sebastian-silaghi/Bandgap-Voltage-Reference/README.md

# Bandgap-Voltage-Reference

Brokaw bandgap voltage reference topology implementation and design.
Internal CMOS technology transistor-level operational amplifier design.
Low PVT variations with second-order compensation.
Low quiescent current and high precision.
The reference voltage remains stable over a wide temperature range (-40°C - 150°C), supply voltage variations (1.6V - 2V) and process.

## Tools
- LTSpice
- Analog design principles

## Results
- Reference voltage ≈ 1.2 V
- Overall PVT variation < 25 mV
