sebastian-silaghi/Bandgap-Voltage-Reference/Documentation/Design of a Bandgap Voltage Reference.pdf

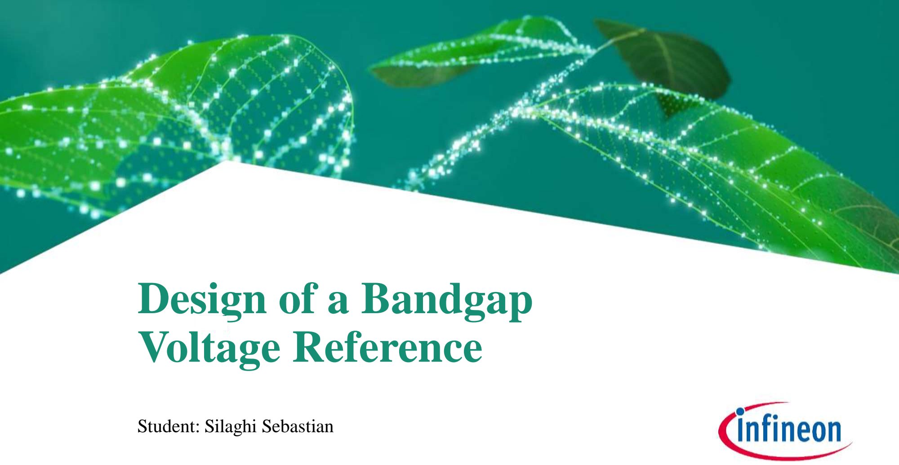
[picture p1: page 1]

# Design of a Bandgap Voltage Reference

Student: Silaghi Sebastian

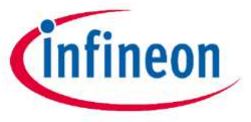
[picture p2: figure]

# Table of Contents

## 1. Bandgap voltage reference design

1.1. Requirements
1.2. Topology
1.3. Operational amplifier design
1.4. Start-up circuit

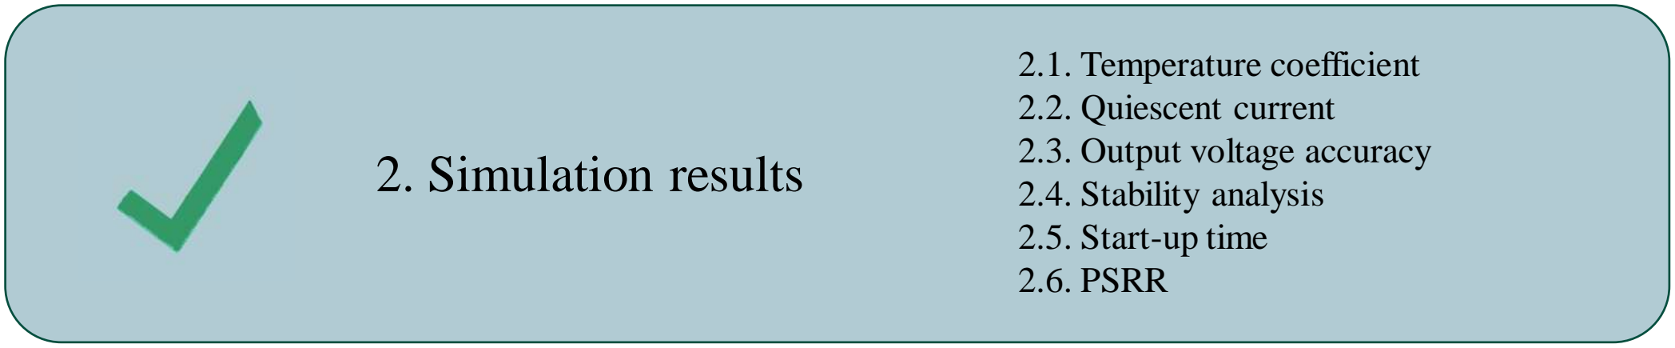
[picture p3: figure]
2. Simulation results; 2.1. Temperature coefficient 2.2. Quiescent current 2.3. Output voltage accuracy 2.4. Stability analysis 2.5. Start-up time 2.6. PSRR

# 1. Bandgap voltage reference design

# 1.1. Requirements

Parameter | Test condition | Min. Value | Typ. Value | Max. Value | Unit
Output voltage | PVT | - | 1.2 | - | V
Precision | - | -3 | - | 3 | %
Supply voltage | - | 1.6 | 1.8 | 2 | V
Resistance tolerance | - | -1 | - | +1 | %
Quiescent current | PVT | - | 30 | - | µA

Tabel 1. Reference voltage requirements

# 1.2. Topology – Brokaw bandgap design steps

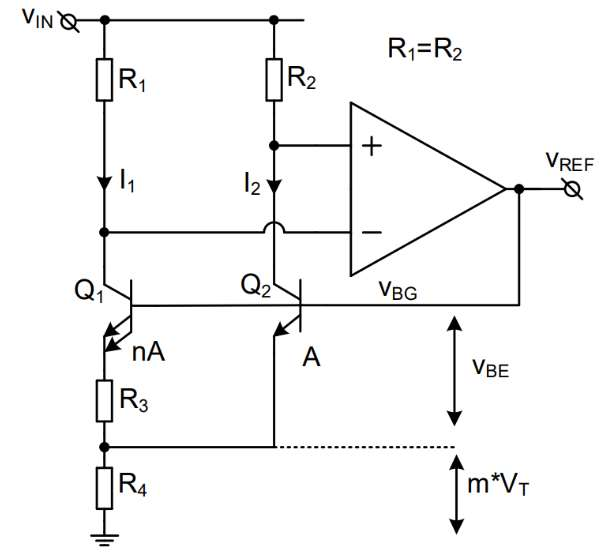
[picture p4: figure]

Figure 1. Voltage reference schematic

The output voltage of the circuit is:

The zero-temperature coefficient condition:

### ∂vBG

∂T

= 0

⇒

2R4
R3

### ⋅ ln n = 23.25

# 1.2. Topology – Brokaw bandgap design steps

Figure 2. Voltage reference schematic

2R4
R3

### ⋅ ln n = 23.25

n = 8

⇒

R4
R3

= 5.6

I1 = I2 = 6µA ⇒

### R3 = 11.2kΩ

### R4 = 55.2kΩ

R1 = R2 ≈

Vin − VBG
I2

≈ 100kΩ

# 1.3. Operational amplifier design – Miller OTA

Main requirements:
a0 > 60dB
PM > 40deg
GM > 10dB
CL = 1pF
IAO = 15µA

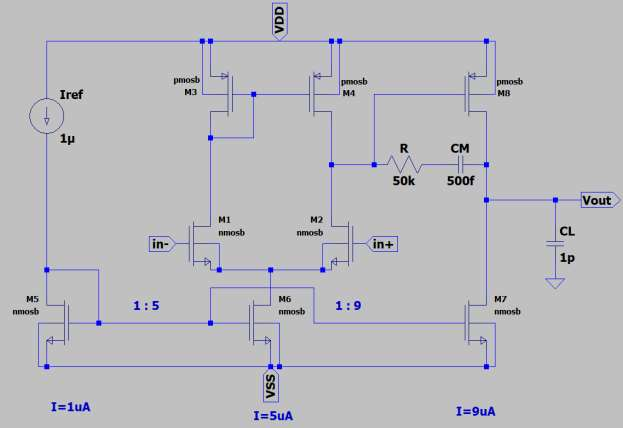
[picture p5: figure]

Figure 3. Schematic of the Miller OTA

Obtained parameters:
a0 = 85dB
PM = 65deg
GM = 15dB
IAO ≈ 15µA
SR = 12V/µs
GBW = 22MHz

# 1.3. Operational amplifier design – Miller OTA

M | Idref | (W/L)ref | Vdsatref | Vthref
NMOS | 50µA | 5µm/1µm | 240mV | 450mV
PMOS | 50µA | 15µm/1µm | 257mV | 450mV

Tabel 2. Reference set transistors

For the sizing of each transistor: Idref Id

=

### WΤL rⅇf WΤL

### Vdsatref Vdsat

2

# 1.3. Operational amplifier design – Miller OTA

M | Id[A] | Vds[V] | Vdsat[V] | gm[S] | W[m] | L[m]
M5 | 1.00E-06 | 6.06E-01 | 1.48E-01 | 1.21E-05 | 2.60E-07 | 1.00E-06
M6 | 4.97E-06 | 1.02E+00 | 1.50E-01 | 5.84E-05 | 1.30E-06 | 1.00E-06
M1 | 2.49E-06 | 3.46E-01 | 6.61E-02 | 5.27E-05 | 5.76E-06 | 1.00E-06
M2 | 2.49E-06 | 3.46E-01 | 6.61E-02 | 5.27E-05 | 5.76E-06 | 1.00E-06
M3 | 2.49E-06 | 6.31E-01 | 1.60E-01 | 2.43E-05 | 2.19E-06 | 1.00E-06
M4 | 2.49E-06 | 6.31E-01 | 1.60E-01 | 2.43E-05 | 2.19E-06 | 1.00E-06
M7 | 9.02E-06 | 1.50E+00 | 1.50E-01 | 1.05E-04 | 2.30E-06 | 1.00E-06
M8 | 9.02E-06 | 5.03E-01 | 1.63E-01 | 8.82E-05 | 7.89E-06 | 1.00E-06
Tabel 3. Miller OTA transistors

# 1.4. Start-up circuit – working principle

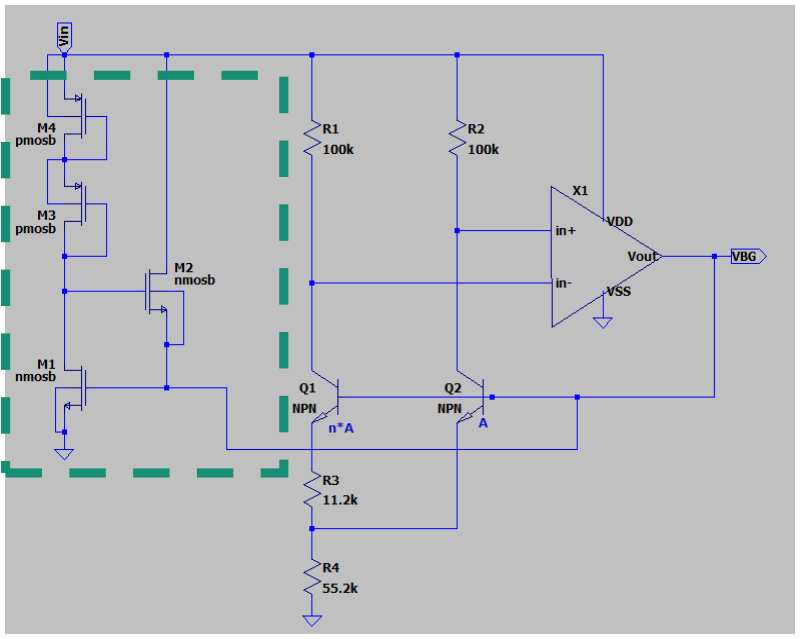
[picture p6: figure]

Figure 4. Bandgap start-up circuit

When VBG = 0 M1 - off, M2 - on and pulls down the gate of M3, M4 => M3, M4 - on and source current from Vin into the core.

When VBG ↑ M1 - on and forces M2 - off and loses its ability to pull down the gate of M3, M4 => M3, M4 - off and no current flowing

# 1.4. Start-up circuit – transient behavior

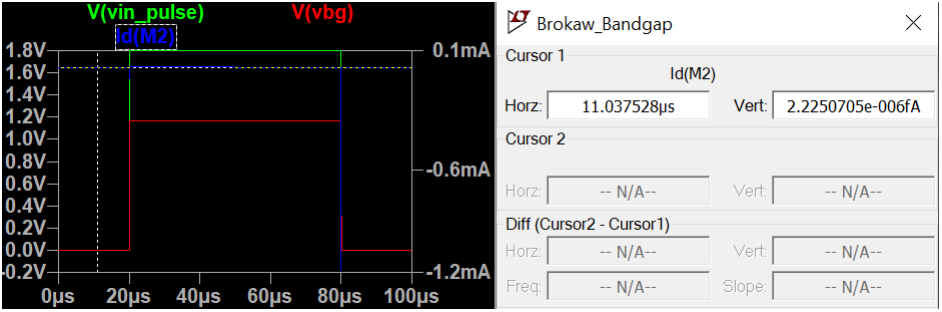
[picture p7: figure]

Figure 5. Transient behavior of start-up circuit

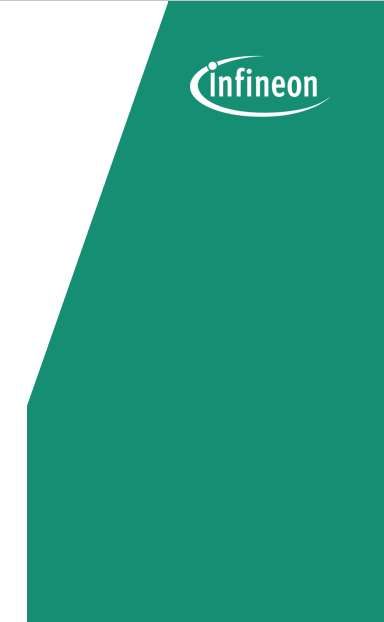
[picture p8: figure]

# 2. Simulation results

# 2.1. Temperature coefficient

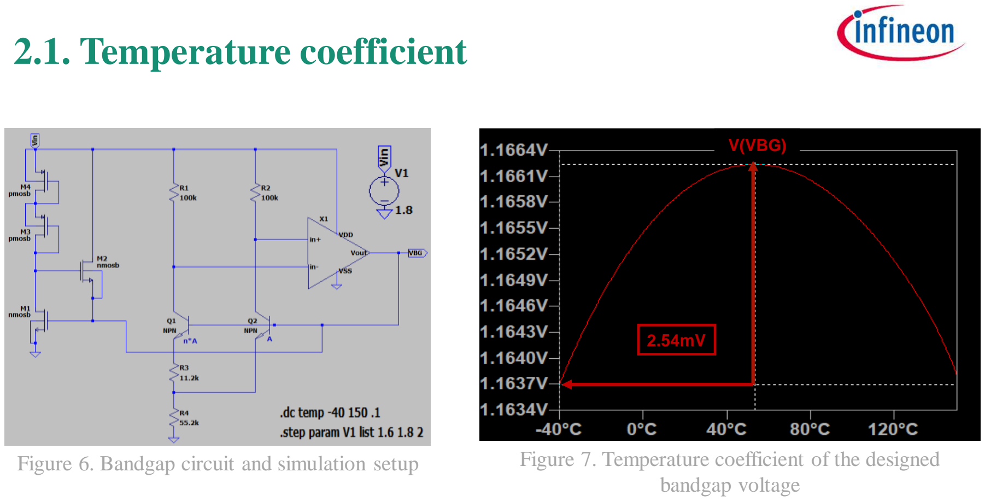
[picture p9: page 13]

Figure 6. Bandgap circuit and simulation setup | Figure 7. Temperature coefficient of the designed bandgap voltage

2.54mV

V(VBG)

## 2.2. Quiescent current – variation with temperature

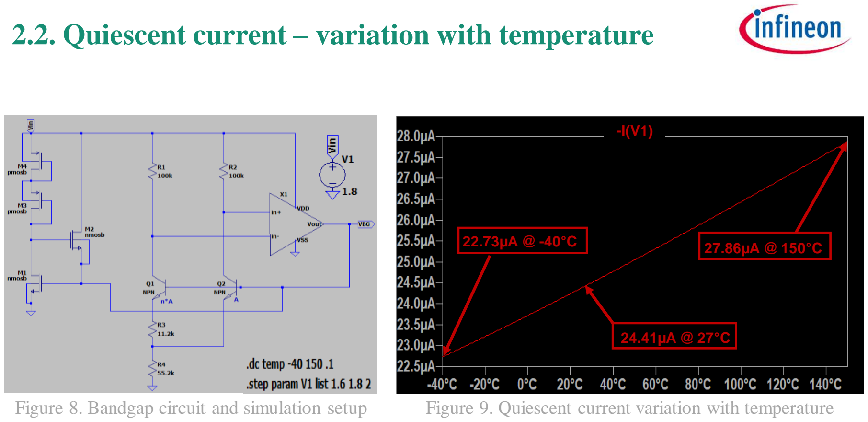
[picture p10: page 14]

Figure 8. Bandgap circuit and simulation setup | Figure 9. Quiescent current variation with temperature

22.73µA @ -40°C

24.41µA @ 27°C

27.86µA @ 150°C

-I(V1)

## 2.2. Quiescent current – variation with supply voltage

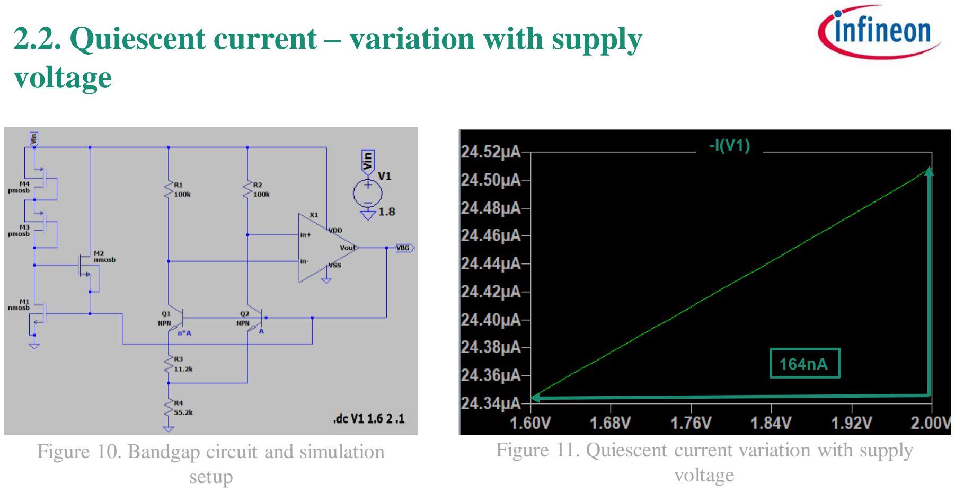
[picture p11: page 15]

Figure 10. Bandgap circuit and simulation setup

Figure 11. Quiescent current variation with supply voltage

164nA

-I(V1)

## 2.2. Quiescent current – MC300 variation with process (resistor tolerance 1%)

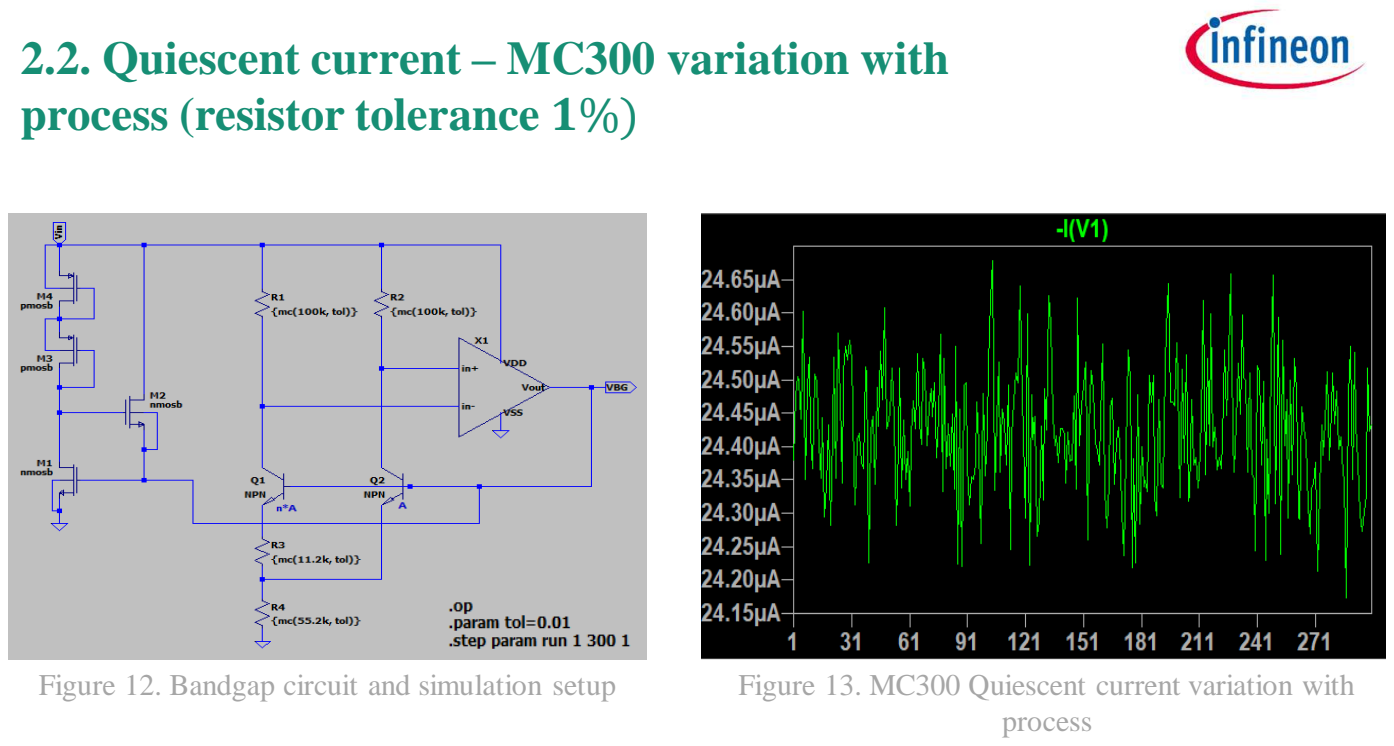
[picture p12: page 16]

Figure 12. Bandgap circuit and simulation setup | Figure 13. MC300 Quiescent current variation with process

## 2.3. Output voltage accuracy – variation across supply voltage

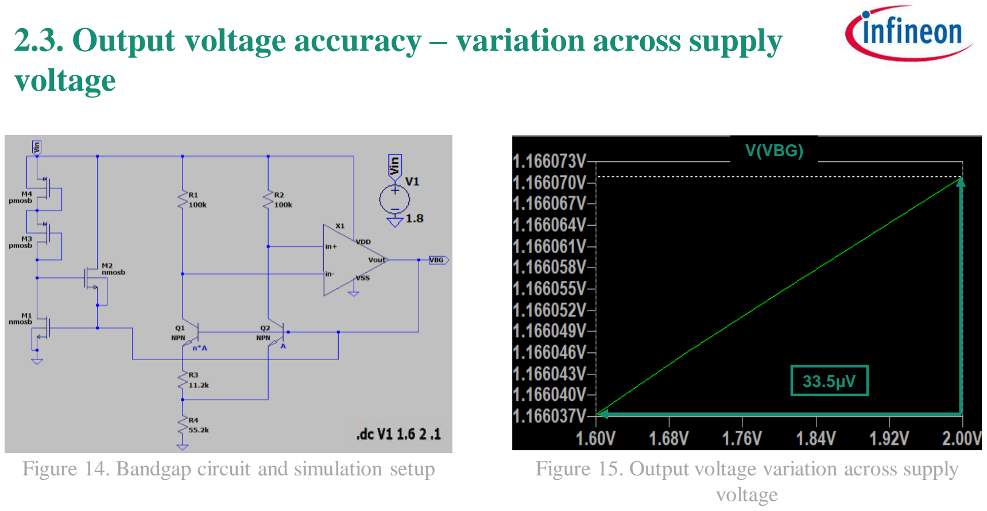
[picture p13: page 17]

Figure 15. Output voltage variation across supply voltage

Figure 14. Bandgap circuit and simulation setup

33.5µV

V(VBG)

## 2.3. Output voltage accuracy – MC300 variation with process (resistor tolerance 1%)

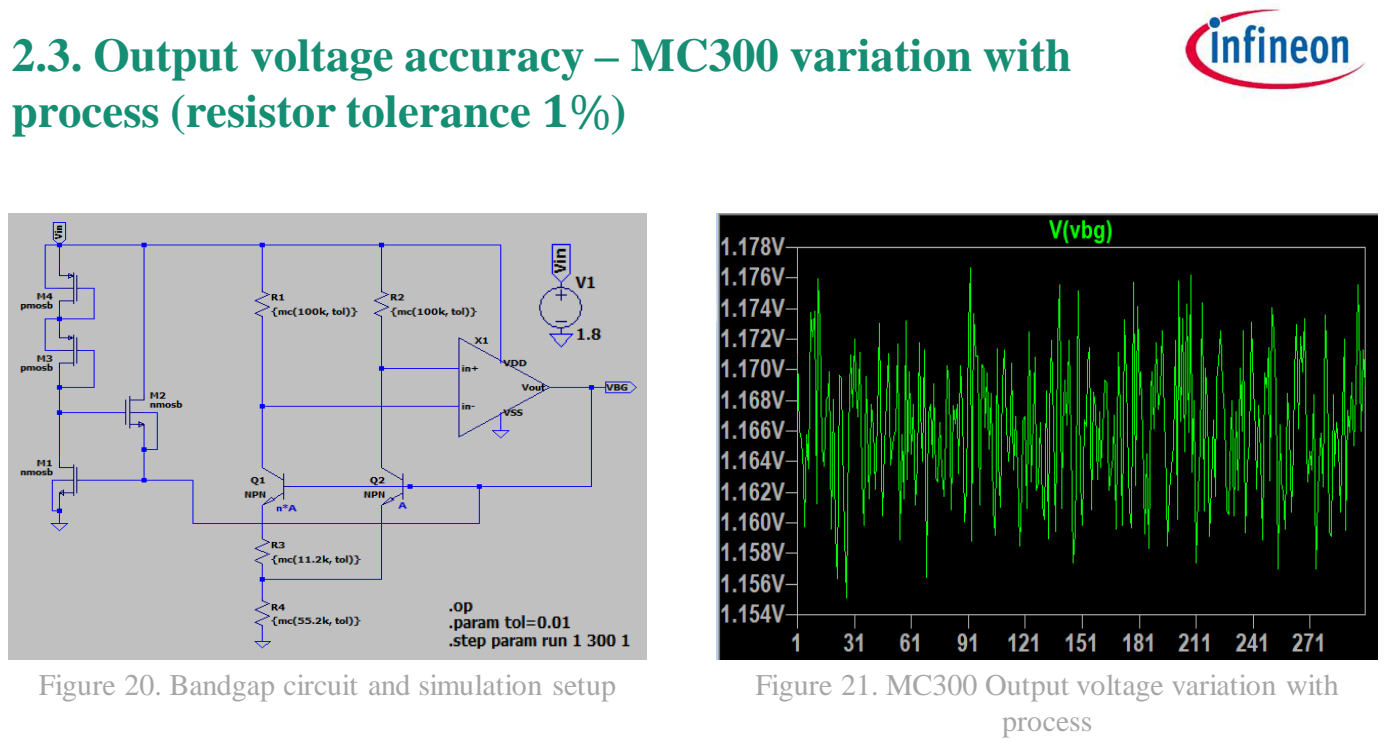
[picture p14: page 18]

Figure 20. Bandgap circuit and simulation setup | Figure 21. MC300 Output voltage variation with process

## 2.3. Output voltage accuracy – MC300 variation with process across temperature (resistor tolerance 1%)

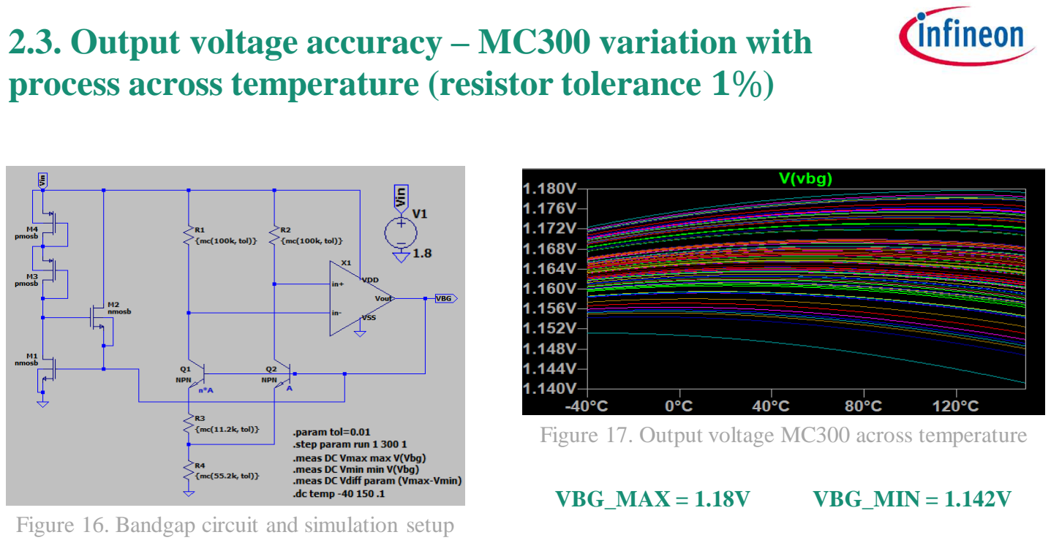
[picture p15: page 19]

Figure 16. Bandgap circuit and simulation setup

Figure 17. Output voltage MC300 across temperature

VBG_MAX = 1.18V | VBG_MIN = 1.142V

## 2.3. Output voltage accuracy – MC300 variation with process across supply voltage (resistor tolerance 1%)

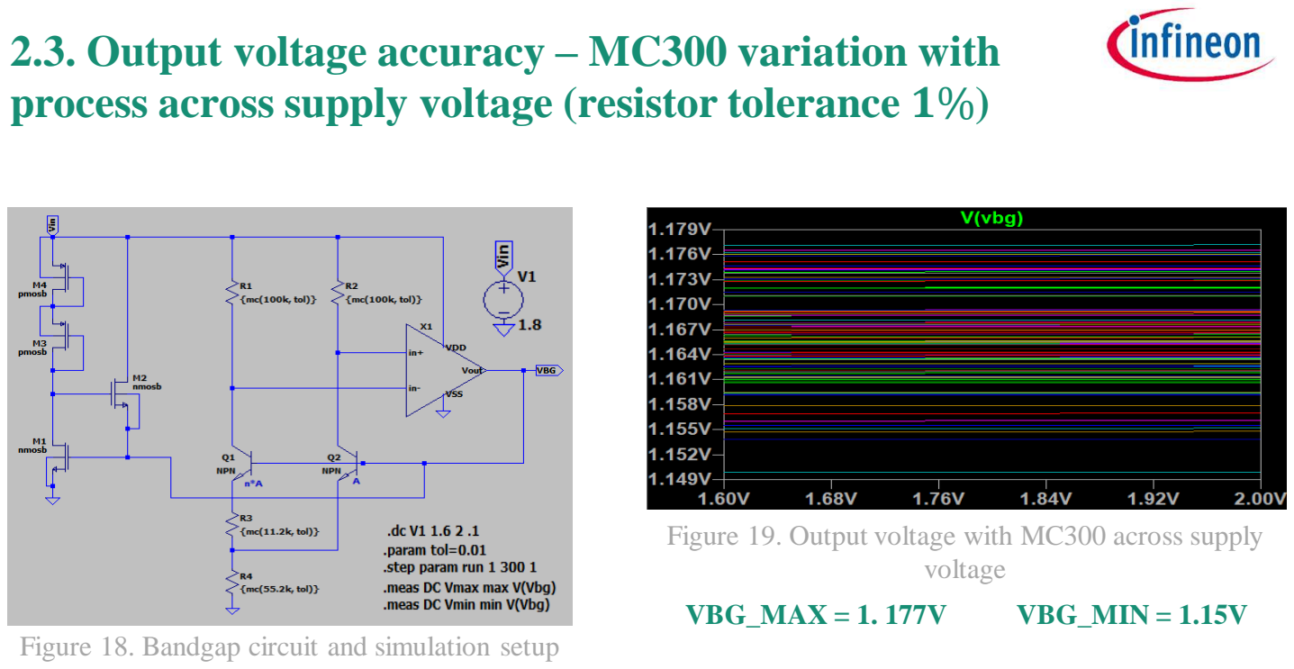
[picture p16: page 20]

Figure 18. Bandgap circuit and simulation setup

Figure 19. Output voltage with MC300 across supply voltage

VBG_MAX = 1. 177V VBG_MIN = 1.15V

## 2.3. Output voltage accuracy – PVT variations

The output voltage variation with temperature = 2.54mV

The output voltage variation with supply voltage = 33.54µV

The output voltage variation with the resistor`s tolerance 1% = 22mV in worst case

Total output voltage variation with PVT = 24.57mV in worst case

Output voltage accuracy = 2.1% in worst case

Improvement: 1.6% output voltage accuracy with 0.5% resistor tolerance in worst case

## 2.4. Stability analysis

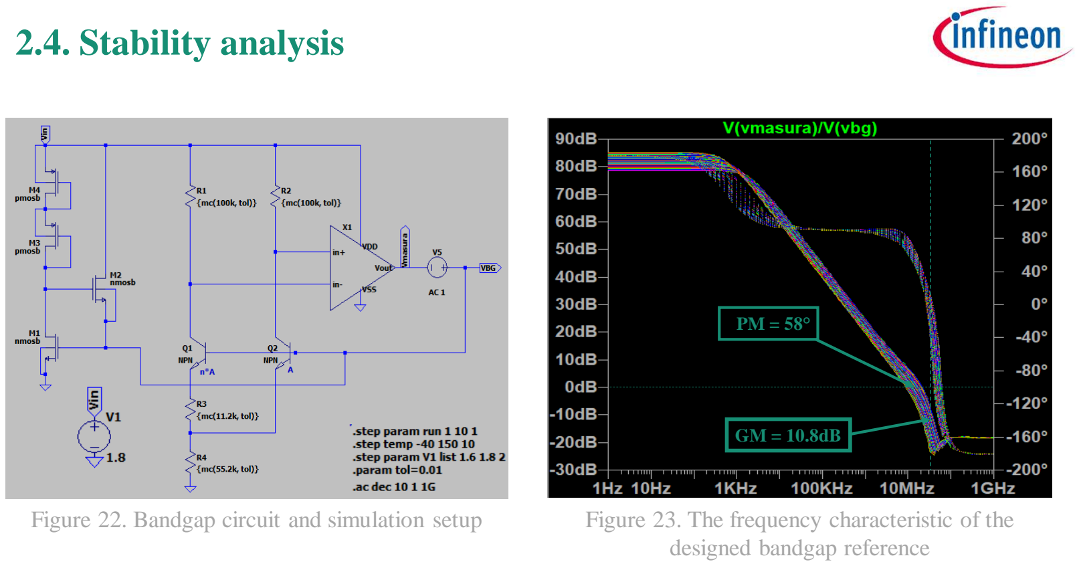
[picture p17: page 22]

Figure 22. Bandgap circuit and simulation setup

PM = 58°

GM = 10.8dB

Figure 23. The frequency characteristic of the designed bandgap reference

## 2.5. Start-up time

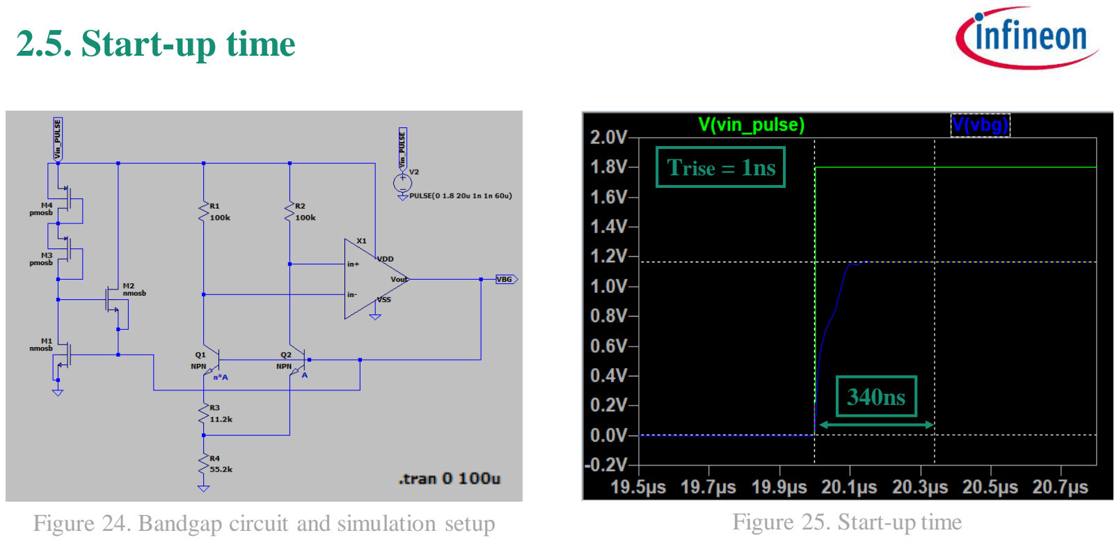
[picture p18: page 23]

Figure 24. Bandgap circuit and simulation setup | Figure 25. Start-up time 340ns

Trise = 1ns

## 2.5. PSRR

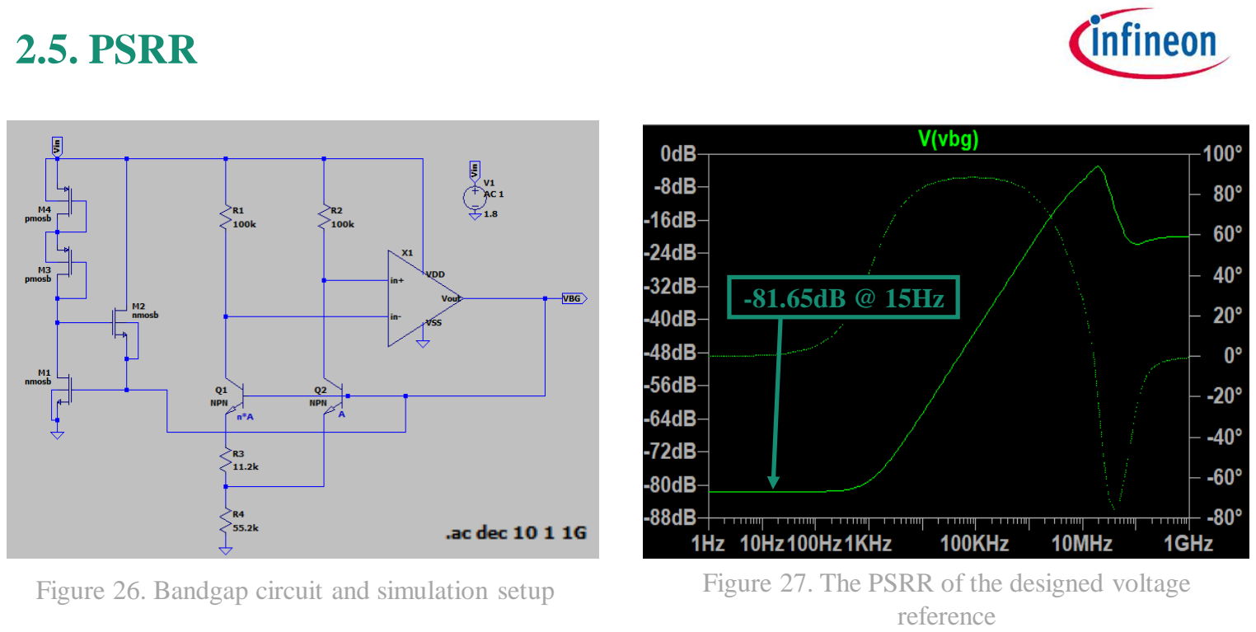
[picture p19: page 24]

Figure 26. Bandgap circuit and simulation setup

-81.65dB @ 15Hz

Figure 27. The PSRR of the designed voltage reference

## Conclusion – Results vs. specifications

Parameter | Required | Obtained
Output voltage | 1.2V | 1.16V
Output voltage accuracy | ±3 | ±2.1
Quiescent current | 30µA | 24.4µA
Phase margin | >40° | 58°
Gain margin | >10dB | 10.8dB

Tabel 4. Bandgap voltage reference requirements vs. obtained results

## Second-order compensation

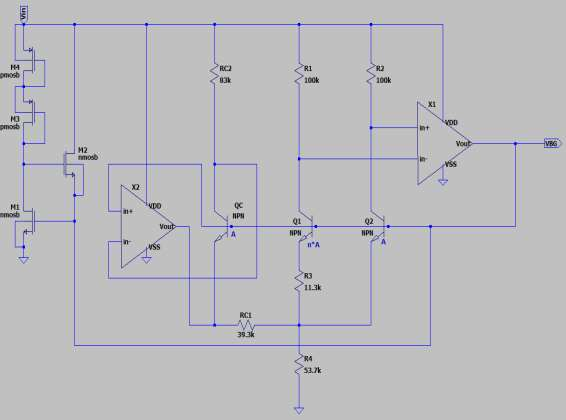
[picture p20: figure]

Figure 28. Second-order compensation circuit

IRC1 =

VBEQC − VBEQ2
RC1 =

ΔVBE
RC1 = VTln

T
T0

·

1
RC1
IRC1 non-linear current for compensation

VBG = VBEQ2 + VR4

= VBEQ2 + I4 ⋅ R4
= VBEQ2 + (I3 + I3 + IRC1) ⋅ R4

= VBEQ2 + 2I3 ⋅ R4 + IRC1 ⋅ R4

=VBG = VBEQ2 +

2R4
R3

VT ln n +

R4
RC1

VTln T
T0

## Second-order compensation

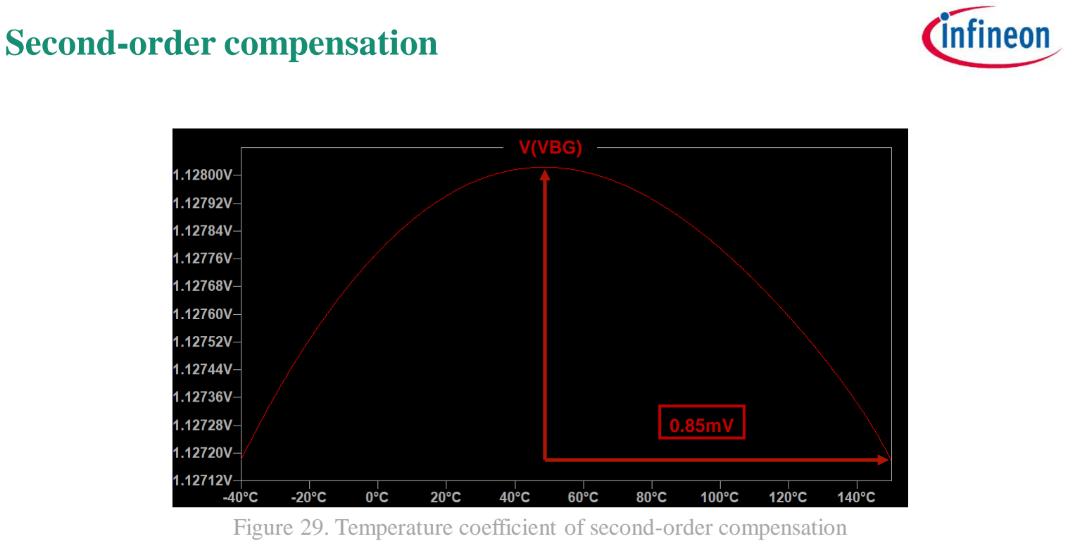
[picture p21: page 27]

Figure 29. Temperature coefficient of second-order compensation

V(VBG)

0.85mV

# Thank you for

# your attention!
