sebastian-silaghi/Bandgap-Voltage-Reference/Simulations/AO_Miller.asc

CL: cap; 1p
CM: cap; 500f
Iref: current; 1µ
M1: nmosb; l=1u w=5.76u
M2: nmosb; l=1u w=5.76u
M3: pmosb; l=1u w=2.19u
M4: pmosb; l=1u w=2.19u
M5: nmosb; l=1u w=0.26u
M6: nmosb; l=1u w=1.3u
M7: nmosb; l=1u w=2.3u
M8: pmosb; l=1u w=7.89u
R: res; 50k
Named nets: in+, in-, VDD, Vout, VSS, 0
.lib tsmc180nmcmos.lib
1 : 5
;WM5=0.26um->1uA=>(ideal) pentru IdM7=9uA->9uA/1uA=9=>WM7=0.26um*9=2.3um
Vdsat5=150m
Id=1u
I=1uA
I=5uA
I=9uA
;Iquiscent_AO=1uA+5uA+9uA=15uA
1 : 9
;Polarizarea corecta a tranzistoarelor
astfel incat Vgs > Vth (~350mV)
Vdsat1=50m
Id=2.5u
Vdsat2=50m
Id=2.5u
Vdsat3=150m
Id=2.5u
Vdsat4=150m
Id=2.5u
Vdsat8=150m
Id=9u
Vdsat7=150m
Id=9u
Vdsat6=150m
Id=5u
;Dimensionarea tranzisoarelor a fost facuta cu tabelul de referinta de la CIA cu adaptare la valorile dorite
;M1, M2 au Vdsat 50mV (minim) pentru un castig cat de mare (gm1,2=2Id1,2/Vdsat1,2) (|A|=Gm_M_in * Rout)
;M3, M4, M5, M6, M7, M8 au Vdsat 150mV ales
;Am pozitionat v+ in dreapta deorece de la acel nod diferential pana la Vout avem numar par de Vgd-uri (2)
;Am pozitionat v- in stanga deoarece de la acel nod diferential pana la Vout avem un numar impar de Vgd-uri (3)
;Supply voltage
;Dimensionarea tranzistoarelor s-a facut cu aceste valori:
(folosind tabelul de referinta)
.op
;CM>0.2*CL
;R=~1/gm_out (~100uS)
