sebastian-silaghi/Bandgap-Voltage-Reference/Simulations/Brokaw_Bandgap.asc

M1: nmosb; l=5u w=0.5u
M2: nmosb; l=10u w=3.84u
M3: pmosb; l=100u w=0.88u
M4: pmosb; l=100u w=0.88u
Q1: npn; AREA=8
Q2: npn; AREA=1
QC: npn; AREA=1
R1: res; 100k; tol=0
R2: res; 100k; tol=0
R3: res; 11.3k; tol=0
R4: res; 53.7k
RC1: res; 39.3k
RC2: res; 83k
V1: voltage; 1.8
V2: voltage; PULSE(0 1.8 20u 1n 1n 60u)
V3: voltage; SINE(1.8 200m 100); AC 1
X1: AO_Miller
X2: AO_Miller
Named nets: 0, Vin, VBG, Vin_PULSE, Vin_PSRR
n*A
A
.op
.dc temp -40 150 .1
.lib tsmc180nmcmos.lib
.tran 0 100u
;For start-up circuit test -> .tran 0 100u
(plot VBG -> 1.2V when Vin_PULSE max ampl)
(plot Id(M2) -> pA/nA when VBG is at nominal value 1.2V)
.step param V1 list 1.6 1.8 2
.ac dec 10 1 1G
;For PSRR test
(plot VBG when .ac dec 10 1 1G with Vin AC = 1 -> -82dB PSSR)
(plot VBG (26uV difference cursor2-cursor1) and Vsupply_PSRR (400mV difference cursor2-cursor1) when .tran 0 100m)
;Quiscent current I(V1) (15uA through OTA, 12uA through BG) across temperature
(plot -I(V1) when .dc temp -40 150 .1 and .step param V1 list 1.6 1.8 2)
.dc V1 1.6 2 .1
;Quiscent current I(V1) variation with resistors tolerance (+/-1%) and temperature
(plot I(V1) when .dc temp -40 150 .1 and .step param V1 list 1.6 1.8 2 and tolerance is +/-1%)
;Output voltage VBG accuracy with PVT variations
variation with VDD supply voltage 1.6-2V
(plot VBG when .dc V1 1.6 2 .1)
variation with temperature
(plot VBG when .dc temp -40 150 .1 and .step param V1 list 1.6 1.8 2)
variation with process (resistor tolerance)-each resistor value should be {mc(value, tol)}
 
Total PVT variation: P+V+T-> approx. accuracy = 2.1%
.param tol=0.01
.step param run 1 300 1
.meas DC Vmax max V(Vbg)
.meas DC Vmin min V(Vbg)
.meas DC Vdiff param (Vmax-Vmin)
;For Monte Carlo analysis for variation with process launch commands below (also launch .dc temp analysis)
;"Bow" characteristic
plot VBG when .dc temp -40 150 .1 and .step param V1 list 1.6 1.8 2
;For stability
place a voltage source AC=1 between VBG (+ terminal at VBG) and Vout_AO, where now Vout_AO will be Vmasura
plot Vmasura/VBG
PM=45deg min with PVT
GM=10.5dB min with PVT
GBW=10-20MHz
A0=80-85dB
;Start-up time
use everything from Start-up circuit test
plot Vsupply_pulse and VBG -> with cursors measure start-up time where VBG is at 90% of nominal value
.step param run 1 10 1
.step temp -40 150 10
.step param V1 list 1.6 1.8 2
.param tol=0.01
;use these commands with .ac analysis, each resistor value should be {mc(*value*, tol)}
A
